Just4Stan/Open-4in1-AM32-ESC-30x30/images/front.png

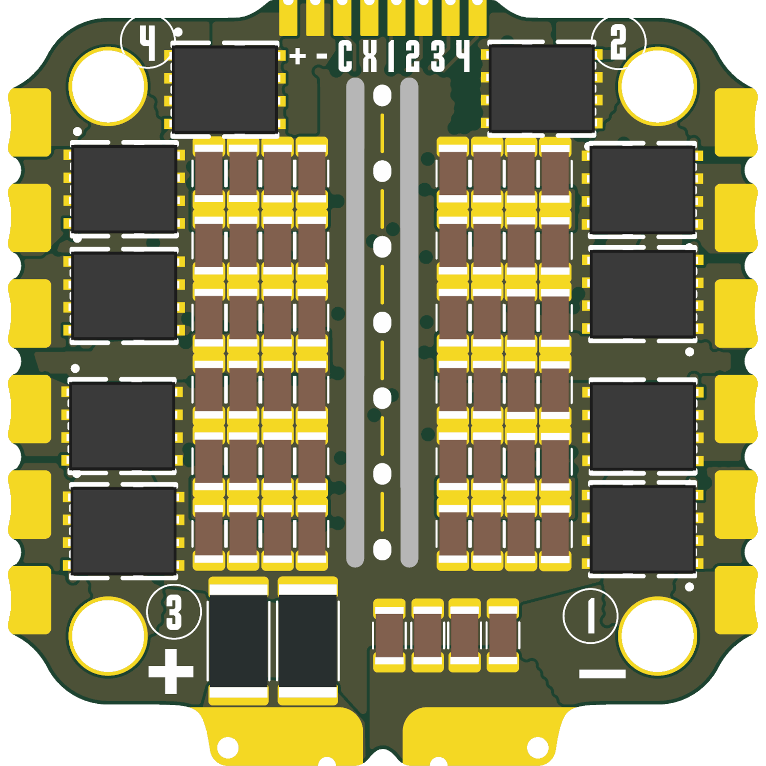
images/front.png
