Just4Stan/Open-4in1-AM32-ESC-30x30/hardware/4in1.kicad_pcb

## KiCad design hardware/4in1.kicad_pcb (2026-09-01)

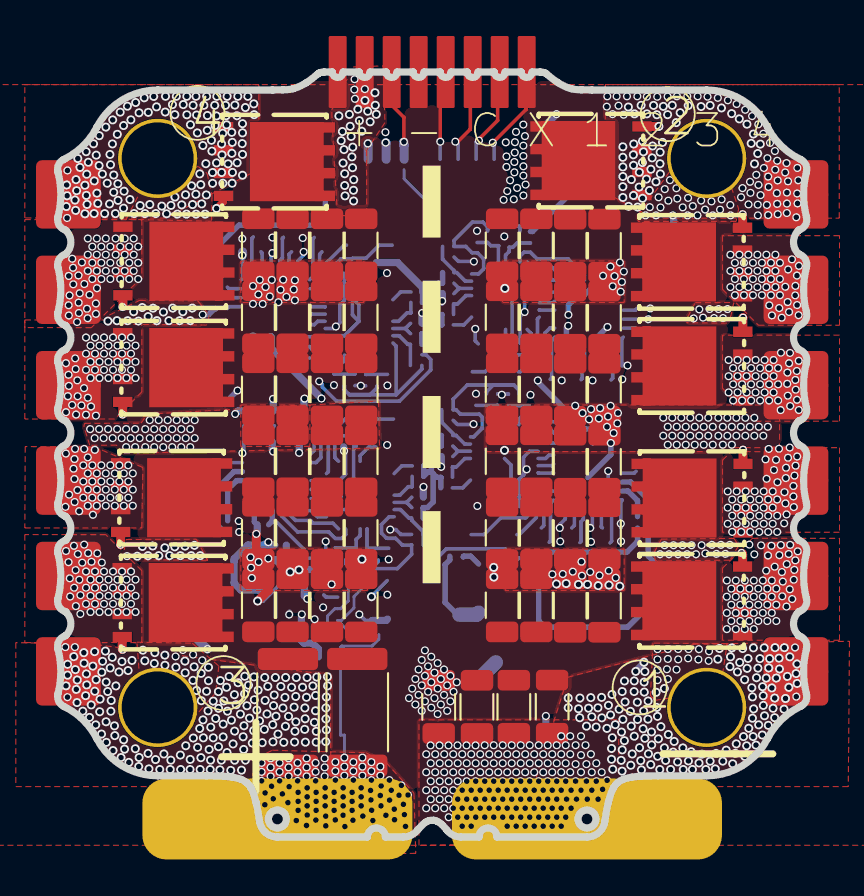
[picture p3: board 4in1.kicad_pcb from above]

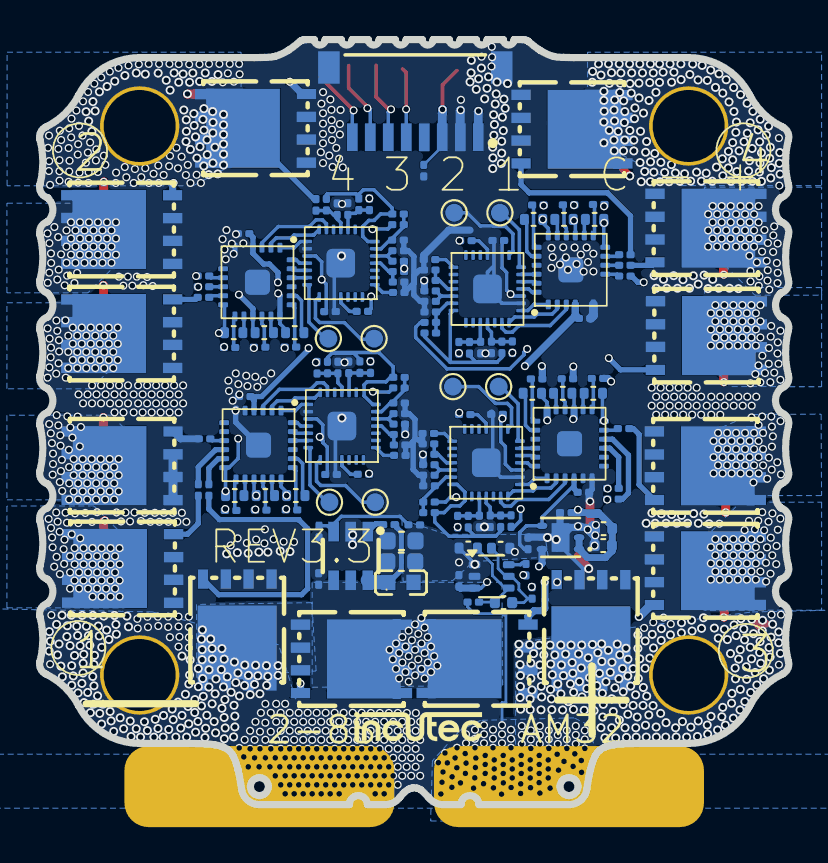
[picture p4: board 4in1.kicad_pcb from below]

Board: 6 copper layers, 41.6 x 42.5 mm, 222 parts (157 on the bottom side), 152 nets.

Parts:
C2, C2#2, C3, C3#2, C6, C8, C9, C13, C13#2, C13#3, C14, C14#2, C14#3, C17, C18, C26, C26#2, C26#3, C27, C27#2, C27#3, C30, C43, C43#2, C43#3, C44, C44#2, C44#3, C69, C70, C82, C82#2, C82#3, C83, C83#2, C83#3, C84, C84#2, C84#3, C85, C85#2, C85#3, C96, C97, C98, C99, C107, C107#2, C107#3, C108, C108#2, C108#3: 4.7uF; C_1206_3216Metric
C4, C51: 22uF; C_0402_1005Metric
C32, C33, C34, C35, C36, C37, C38, C39, C40, C41, C53, C56, C62, C67: 100nF; C_0402_WIDE
C42: 1uF; C_0402_1005Metric
C47, C86: 22uF; C_0603_1608Metric
C48, C49, C50, C52, C54, C55, C57, C58, C59, C60, C61, C63, C64, C65, C66, C68, C74, C75, C76, C81, C93, C94: 100nF; C_0201_0603Metric
J1: SM08B-SRSS-TB; JST_SM08B-SRSS-TB
Q1, Q2, Q3, Q4, Q5, Q6, Q7, Q8, Q9, Q10, Q11, Q12, Q13, Q14, Q15, Q16, Q17, Q18, Q19, Q20, Q21, Q22, Q23, Q24: SP40N01GHNK; PDFN-8L_L6.0-W5.0-P1.27
R10, R12, R13, R15, R25, R27, R28, R30, R31, R33, R34, R36, R46, R48, R49, R51, R52, R54, R64, R66, R67, R69, R70, R72: 10k; C_0201_0603Metric
R11, R14, R26, R29, R32, R35, R47, R50, R53, R65, R68, R71, R73, R89, R90: 1k; C_0201_0603Metric
R18, R19, R21, R22, R40, R41, R58, R59, R121: 10k; R_0201_0603Metric
R20, R39, R57, R87: 220R; R_0201_0603Metric
R23, R24, R37, R38, R42, R43, R44, R45, R55, R56, R60, R61, R62, R63, R74, R75, R76, R77, R78, R79, R80, R81, R82, R83: 15R; R_0201_0603Metric
R84, R85, R86, R88: 10R; R_0201_0603Metric
R120: 115k; R_0201_0603Metric
Rsense1, Rsense2: 0.2mR; R_2512_6332Metric
TP1, TP2, TP3, TP4, TP5, TP6, TP7, TP8: TestPoint; TestPoint_Pad_D1.0mm
U2, U5, U7, U9: AT32F421G8U7; QFN-28_L4.0-W4.0-P0.40-TL-EP2.4
U3: 4in1ESC30x30
U4, U6, U8, U10: NSG2065Q; QFN-24_L4.0-W4.0-P0.50-TL-EP2.8
U12: INA186A3IDCKR; SOT-363_SC-70-6
U13: LMR54406DBVR; SOT-23-6_L2.9-W1.6-P0.95-LS2.8-BR
U14: FTC160808S4R7MBCA; IND-SMD_L1.6-W0.8_FTC160865SR47MBCA
U15: TLV76733DRVR; WSON-6_L2.0-W2.0-P0.65-TL-EP

Connections:
+3V3: C4.2, C49.1, C51.2, C55.1, C61.1, C66.1, C81.1, C93.1, R18.2, R21.2, R40.2, R58.2, R84.2, R85.2, R86.2, R88.2, U2.17 (VDD), U5.17 (VDD), U7.17 (VDD), U9.17 (VDD), U12.3 (VS), U15.1 (OUT), U15.2 (FB/SNS)
+10V: C47.1, C57.1, C58.1, C63.1, C68.1, C76.1, C86.1, R120.1, U4.4 (VCC), U6.4 (VCC), U8.4 (VCC), U10.4 (VCC), U14.2, U15.4 (EN), U15.6 (IN)
+BATT: C2.1, C2#2.1, C3.1, C3#2.1, C6.1, C8.1, C9.1, C13.1, C13#2.1, C13#3.1, C14.1, C14#2.1, C14#3.1, C17.1, C18.1, C26.1, C26#2.1, C26#3.1, C27.1, C27#2.1, C27#3.1, C30.1, C43.1, C43#2.1, C43#3.1, C44.1, C44#2.1, C44#3.1, C69.1, C70.1, C74.1, C82.1, C82#2.1, C82#3.1, C83.1, C83#2.1, C83#3.1, C84.1, C84#2.1, C84#3.1, C85.1, C85#2.1, C85#3.1, C96.1, C97.1, C98.1, C99.1, C107.1, C107#2.1, C107#3.1, C108.1, C108#2.1, C108#3.1, J1.1, Q1.3 (D), Q6.3 (D), Q7.3 (D), Q8.3 (D), Q9.3 (D), Q10.3 (D), Q13.3 (D), Q16.3 (D), Q17.3 (D), Q18.3 (D), Q19.3 (D), Q20.3 (D), R89.2, Rsense1.2, Rsense2.2, U3.3 (VBAT+), U13.4 (EN), U13.5 (VIN)
/CSA+: R90.2, Rsense1.1, Rsense2.1, U3.1 (VBAT)
/CURR: C94.1, J1.3, R73.1, U3.5 (CUR)
/ESC1/AH: U2.20 (PA10), U4.22 (HIN1)
/ESC1/AL: U2.15 (PB1), U4.1 (LIN1)
/ESC1/BH: U2.19 (PA9), U4.23 (HIN2)
/ESC1/BL: U2.14 (PB0), U4.2 (LIN2)
/ESC1/CH: U2.18 (PA8), U4.24 (HIN3)
/ESC1/CL: U2.13 (PA7), U4.3 (LIN3)
/ESC1/FBA: R25.1, R26.2, R27.2, U2.6 (PA0)
/ESC1/FBB: R28.2, R29.2, R30.2, U2.10 (PA4)
/ESC1/FBC: R31.2, R32.2, R33.2, U2.11 (PA5)
/ESC1/FBCOMMON: R25.2, R28.1, R31.1, U2.7 (PA1)
/ESC1/GHA: R76.1, U4.19 (HO1)
/ESC1/GHB: R55.1, U4.16 (HO2)
/ESC1/GHC: R23.1, U4.13 (HO3)
/ESC1/GLA: R80.1, U4.11 (LO1)
/ESC1/GLB: R62.1, U4.10 (LO2)
/ESC1/GLC: R42.1, U4.9 (LO3)
/ESC1/MotorA: C53.1, Q1.1 (S), Q2.3 (D), R27.1, U3.23 (1A), U4.18 (VS1)
/ESC1/MotorB: C32.1, Q6.1 (S), Q11.3 (D), R30.1, U3.22 (1B), U4.15 (VS2)
/ESC1/MotorC: C36.1, Q16.1 (S), Q21.3 (D), R33.1, U3.21 (1C), U4.12 (VS3)
/ESC1/vdda: C48.1, R84.1, U2.5 (VDDA)
/ESC2/AH: U5.20 (PA10), U6.22 (HIN1)
/ESC2/AL: U5.15 (PB1), U6.1 (LIN1)
/ESC2/BH: U5.19 (PA9), U6.23 (HIN2)
/ESC2/BL: U5.14 (PB0), U6.2 (LIN2)
/ESC2/CH: U5.18 (PA8), U6.24 (HIN3)
/ESC2/CL: U5.13 (PA7), U6.3 (LIN3)
/ESC2/FBA: R10.1, R11.2, R12.2, U5.6 (PA0)
/ESC2/FBB: R13.2, R14.2, R15.2, U5.10 (PA4)
/ESC2/FBC: R34.2, R35.2, R36.2, U5.11 (PA5)
/ESC2/FBCOMMON: R10.2, R13.1, R34.1, U5.7 (PA1)
/ESC2/GHA: R77.1, U6.19 (HO1)
/ESC2/GHB: R56.1, U6.16 (HO2)
/ESC2/GHC: R24.1, U6.13 (HO3)
/ESC2/GLA: R81.1, U6.11 (LO1)
/ESC2/GLB: R63.1, U6.10 (LO2)
/ESC2/GLC: R43.1, U6.9 (LO3)
/ESC2/MotorA: C56.1, Q3.3 (D), Q7.1 (S), R12.1, U3.20 (2B), U6.18 (VS1)
/ESC2/MotorB: C33.1, Q8.1 (S), Q12.3 (D), R15.1, U3.19 (2C), U6.15 (VS2)
/ESC2/MotorC: C37.1, Q17.1 (S), Q22.3 (D), R36.1, U3.18 (2A), U6.12 (VS3)
/ESC2/vdda: C54.1, R85.1, U5.5 (VDDA)
/ESC3/AH: U7.20 (PA10), U8.22 (HIN1)
/ESC3/AL: U7.15 (PB1), U8.1 (LIN1)
/ESC3/BH: U7.19 (PA9), U8.23 (HIN2)
/ESC3/BL: U7.14 (PB0), U8.2 (LIN2)
/ESC3/CH: U7.18 (PA8), U8.24 (HIN3)
/ESC3/CL: U7.13 (PA7), U8.3 (LIN3)
/ESC3/FBA: R46.1, R47.2, R48.2, U7.6 (PA0)
/ESC3/FBB: R49.2, R50.2, R51.2, U7.10 (PA4)
/ESC3/FBC: R52.2, R53.2, R54.2, U7.11 (PA5)
/ESC3/FBCOMMON: R46.2, R49.1, R52.1, U7.7 (PA1)
/ESC3/GHA: R78.1, U8.19 (HO1)
/ESC3/GHB: R60.1, U8.16 (HO2)
/ESC3/GHC: R37.1, U8.13 (HO3)
/ESC3/GLA: R82.1, U8.11 (LO1)
/ESC3/GLB: R74.1, U8.10 (LO2)
/ESC3/GLC: R44.1, U8.9 (LO3)
/ESC3/MotorA: C62.1, Q4.3 (D), Q13.1 (S), R48.1, U3.15 (3B), U8.18 (VS1)
/ESC3/MotorB: C34.1, Q9.1 (S), Q14.3 (D), R51.1, U3.16 (3C), U8.15 (VS2)
/ESC3/MotorC: C38.1, Q18.1 (S), Q23.3 (D), R54.1, U3.17 (3A), U8.12 (VS3)
/ESC3/vdda: C60.1, R86.1, U7.5 (VDDA)
/ESC4/AH: U9.20 (PA10), U10.22 (HIN1)
/ESC4/AL: U9.15 (PB1), U10.1 (LIN1)
/ESC4/BH: U9.19 (PA9), U10.23 (HIN2)
/ESC4/BL: U9.14 (PB0), U10.2 (LIN2)
/ESC4/CH: U9.18 (PA8), U10.24 (HIN3)
/ESC4/CL: U9.13 (PA7), U10.3 (LIN3)
/ESC4/FBA: R64.1, R65.2, R66.2, U9.6 (PA0)
/ESC4/FBB: R67.2, R68.2, R69.2, U9.10 (PA4)
/ESC4/FBC: R70.2, R71.2, R72.2, U9.11 (PA5)
/ESC4/FBCOMMON: R64.2, R67.1, R70.1, U9.7 (PA1)
/ESC4/GHA: R79.1, U10.19 (HO1)
/ESC4/GHB: R61.1, U10.16 (HO2)
/ESC4/GHC: R38.1, U10.13 (HO3)
/ESC4/GLA: R83.1, U10.11 (LO1)
/ESC4/GLB: R75.1, U10.10 (LO2)
/ESC4/GLC: R45.1, U10.9 (LO3)
/ESC4/MotorA: C67.1, Q5.3 (D), Q19.1 (S), R66.1, U3.12 (4A), U10.18 (VS1)
/ESC4/MotorB: C35.1, Q10.1 (S), Q15.3 (D), R69.1, U3.13 (4B), U10.15 (VS2)
/ESC4/MotorC: C39.1, Q20.1 (S), Q24.3 (D), R72.1, U3.14 (4C), U10.12 (VS3)
/ESC4/vdda: C65.1, R88.1, U9.5 (VDDA)
/M1: J1.5, R20.1, U3.7 (M1)
/M2: J1.6, R39.1, U3.8 (M2)
/M3: J1.7, R57.1, U3.9 (M3)
/M4: J1.8, R87.1, U3.10 (M4)
GND: C2.2, C2#2.2, C3.2, C3#2.2, C4.1, C6.2, C8.2, C9.2, C13.2, C13#2.2, C13#3.2, C14.2, C14#2.2, C14#3.2, C17.2, C18.2, C26.2, C26#2.2, C26#3.2, C27.2, C27#2.2, C27#3.2, C30.2, C40.2, C41.2, C43.2, C43#2.2, C43#3.2, C44.2, C44#2.2, C44#3.2, C47.2, C48.2, C49.2, C50.2, C51.1, C52.2, C54.2, C55.2, C57.2, C58.2, C59.2, C60.2, C61.2, C63.2, C64.2, C65.2, C66.2, C68.2, C69.2, C70.2, C74.2, C76.2, C81.2, C82.2, C82#2.2, C82#3.2, C83.2, C83#2.2, C83#3.2, C84.2, C84#2.2, C84#3.2, C85.2, C85#2.2, C85#3.2, C86.2, C93.2, C94.2, C96.2, C97.2, C98.2, C99.2, C107.2, C107#2.2, C107#3.2, C108.2, C108#2.2, C108#3.2, J1.2, J1.P1 (MP1), J1.P2 (MP2), Q2.1 (S), Q3.1 (S), Q4.1 (S), Q5.1 (S), Q11.1 (S), Q12.1 (S), Q14.1 (S), Q15.1 (S), Q21.1 (S), Q22.1 (S), Q23.1 (S), Q24.1 (S), R11.1, R14.1, R19.2, R22.2, R26.1, R29.1, R32.1, R35.1, R41.2, R47.1, R50.1, R53.1, R59.2, R65.1, R68.1, R71.1, R121.2, U2.16 (VSS), U2.29 (VSS), U3.2 (BATGND), U3.4 (GND), U3.11 (Hole), U4.6 (COM), U4.25 (COM), U5.16 (VSS), U5.29 (VSS), U6.6 (COM), U6.25 (COM), U7.16 (VSS), U7.29 (VSS), U8.6 (COM), U8.25 (COM), U9.16 (VSS), U9.29 (VSS), U10.6 (COM), U10.25 (COM), U12.1 (REF), U12.2 (GND), U13.2 (GND), U15.3 (GND), U15.5 (GND), U15.7 (EP)
unnamed: Q1.2 (G), R76.2
unnamed: Q2.2 (G), R80.2
unnamed: Q3.2 (G), R81.2
unnamed: Q4.2 (G), R82.2
unnamed: Q5.2 (G), R83.2
unnamed: Q6.2 (G), R55.2
unnamed: Q7.2 (G), R77.2
unnamed: Q8.2 (G), R56.2
unnamed: Q9.2 (G), R60.2
unnamed: Q10.2 (G), R61.2
unnamed: Q11.2 (G), R62.2
unnamed: Q12.2 (G), R63.2
unnamed: Q13.2 (G), R78.2
unnamed: Q14.2 (G), R74.2
unnamed: Q15.2 (G), R75.2
unnamed: Q16.2 (G), R23.2
unnamed: Q17.2 (G), R24.2
unnamed: Q18.2 (G), R37.2
unnamed: Q19.2 (G), R79.2
unnamed: Q20.2 (G), R38.2
unnamed: Q21.2 (G), R42.2
unnamed: Q22.2 (G), R43.2
unnamed: Q23.2 (G), R44.2
unnamed: Q24.2 (G), R45.2
unnamed: R19.1, U2.1 (BOOT0)
unnamed: C50.1, R18.1, U2.4 (NRST)
unnamed: TP1.1 (1_1), U2.21 (PA13)
unnamed: TP4.1 (1_1), U2.22 (PA14)
unnamed: R20.2, U2.25 (PB4)
unnamed: C53.2, U4.20 (VB1)
unnamed: C32.2, U4.17 (VB2)
unnamed: C36.2, U4.14 (VB3)
unnamed: R22.1, U5.1 (BOOT0)
unnamed: C52.1, R21.1, U5.4 (NRST)
unnamed: TP2.1 (1_1), U5.21 (PA13)
unnamed: TP5.1 (1_1), U5.22 (PA14)
unnamed: R39.2, U5.25 (PB4)
unnamed: C56.2, U6.20 (VB1)
unnamed: C33.2, U6.17 (VB2)
unnamed: C37.2, U6.14 (VB3)
unnamed: R41.1, U7.1 (BOOT0)
unnamed: C59.1, R40.1, U7.4 (NRST)
unnamed: TP3.1 (1_1), U7.21 (PA13)
unnamed: TP6.1 (1_1), U7.22 (PA14)
unnamed: R57.2, U7.25 (PB4)
unnamed: C62.2, U8.20 (VB1)
unnamed: C34.2, U8.17 (VB2)
unnamed: C38.2, U8.14 (VB3)
unnamed: R59.1, U9.1 (BOOT0)
unnamed: C64.1, R58.1, U9.4 (NRST)
unnamed: TP7.1 (1_1), U9.21 (PA13)
unnamed: TP8.1 (1_1), U9.22 (PA14)
unnamed: R87.2, U9.25 (PB4)
unnamed: C67.2, U10.20 (VB1)
unnamed: C35.2, U10.17 (VB2)
unnamed: C39.2, U10.14 (VB3)
unnamed: C41.1, C42.2, R90.1, U12.4 (+IN)
unnamed: C40.1, C42.1, R89.1, U12.5 (-IN)
unnamed: R73.2, U12.6 (OUT)
unnamed: C75.2, U13.1 (CB)
unnamed: R120.2, R121.1, U13.3 (FB)
unnamed: C75.1, U13.6 (SW), U14.1
