Just4Stan/Open-4in1-AM32-ESC-30x30/(commit log)

2026-08-25 schematics: fill Manufacturer on every part with an LCSC number
    Every placed part now carries LCSC + Manufacturer + MPN, manufacturer names
    from the LCSC catalogue. Feeds OpenDrone-Scripts kicad/universal_bom.py for
    quoting outside JLCPCB; its output matches the rev3.2 Toolkit BOM exactly
    (21 lines, 213 placements).
    kicad-skip reflowed the files on write; S-expression structural diff against
    the originals shows only the property changes, ERC identical before and
    after (350 violations, same categories).
    [4in1.kicad_sch, ESC.kicad_sch]
2026-08-25 components: fill Manufacturer and MPN on placed library symbols
    Copied from the standardised schematic instances: INA186A3IDCKR,
    NSG2065Q, SM08B-SRSS-TB, TLV76733DRVR. XRIM160808SR47MBCD left
    alone: its schematic instance carries a different part (C46594347
    FTC160808S4R7MBCA), needs a human call.
2026-08-25 Swap bulk caps to FH 1206B475K500NT 4.7uF 50V (C29823)
    Replaces Samsung CL31B106KBHNNNE 10uF (C89632) on schematic symbols
    C2/C3/C6 and all 70 panel-board footprints. Cost cut: NextPCB priced
    the 10uF at $0.218/pc; the FH part is ~$0.03 and a JLCPCB basic part.
    Single-board file 4in1.kicad_pcb also swapped (52 footprints) but left
    uncommitted: it carries unrelated WIP silkscreen changes.
    [4in1-panel.kicad_pcb, 4in1.kicad_sch]
2026-08-25 Rebrand back silkscreen to incutec, 4.7uF bulk caps on board
    incutec silkscreen text added by Stan; bulk cap footprint fields
    swapped to FH 1206B475K500NT 4.7uF 50V C29823 matching the committed
    schematic change.
    [4in1.kicad_pcb]
2026-08-25 Sync silkscreen rev text to REV3.2 (pipeline rev sync)
    [4in1.kicad_pcb]
2026-08-25 Rebrand silkscreen to incutec, final rev3.3 pass (Stan)
    [4in1.kicad_pcb]
2026-08-25 AGENTS: record rev3.3; rev silk synced by pipeline
    [4in1.kicad_pcb]
2026-08-25 Re-render README images with incutec silkscreen
2026-08-26 Swap bulk caps to CCTC TCC1206X7R475K500HT (C380366)
    FH C29823 was picked for its JLC-basic price; at LCSC retail it costs
    USD 0.19/pc and we are no longer using JLCPCB assembly. CCTC part is
    ~USD 0.073/pc at 4k+ volume, same 4.7uF 10% 50V X7R 1206 class.
    Fields only (LCSC/MPN/Manufacturer), no value, footprint or net changes.
    [4in1-panel.kicad_pcb, 4in1.kicad_pcb, 4in1.kicad_sch]
2026-08-27 AGENTS: log TPHR8504PL as alternate FET
    Toshiba 40 V SOP Advance, LCSC C22388172. Lower RDS(on) than the fitted
    SP40N01GHNK (0.85 vs 1.5 mOhm max at VGS 10 V) but EAS 336 mJ vs 1089 mJ,
    which is the board's only overvoltage backstop. Recorded, not selected.
2026-08-27 AGENTS: point FET and driver rows at KiCad-Library ALTERNATES.md
    Replaces the inline alternates note with a link, so the shared gate driver
    list is not restated in three board repos. Also drops the unqualified
    "drop-in successor" claim for XRS280N03C: it is 30 V VDSS and this board
    is rated to 8S, 33.6 V charged.
2026-08-31 AGENTS.md: sync from the bench mirror rework (#37)
    Formatting repairs plus verified corrections from the 2026-08-31 bench
    session (fact-checked against datasheets, board READMEs and firmware
    sources). Details per file in OpenDrone-Testing commit 06034b3.
2026-09-01 chore: standardize OpenESC-3030 assets and guidance
    [4in1-panel.kicad_pcb, 4in1.kicad_pcb]
2026-09-01 Adopt shared KiCad datasheets
